bchelf/keyboard-nes/README.md

# keyboard-nes

Remapping order: Right, Left, Down, Up, A, B, Select, Start
