bchelf/keyboard-nes/hardware/kbd-nes-v2/kbd-nes-v2.kicad_pcb

## KiCad design hardware/kbd-nes-v2/kbd-nes-v2.kicad_pcb (2026-05-14)

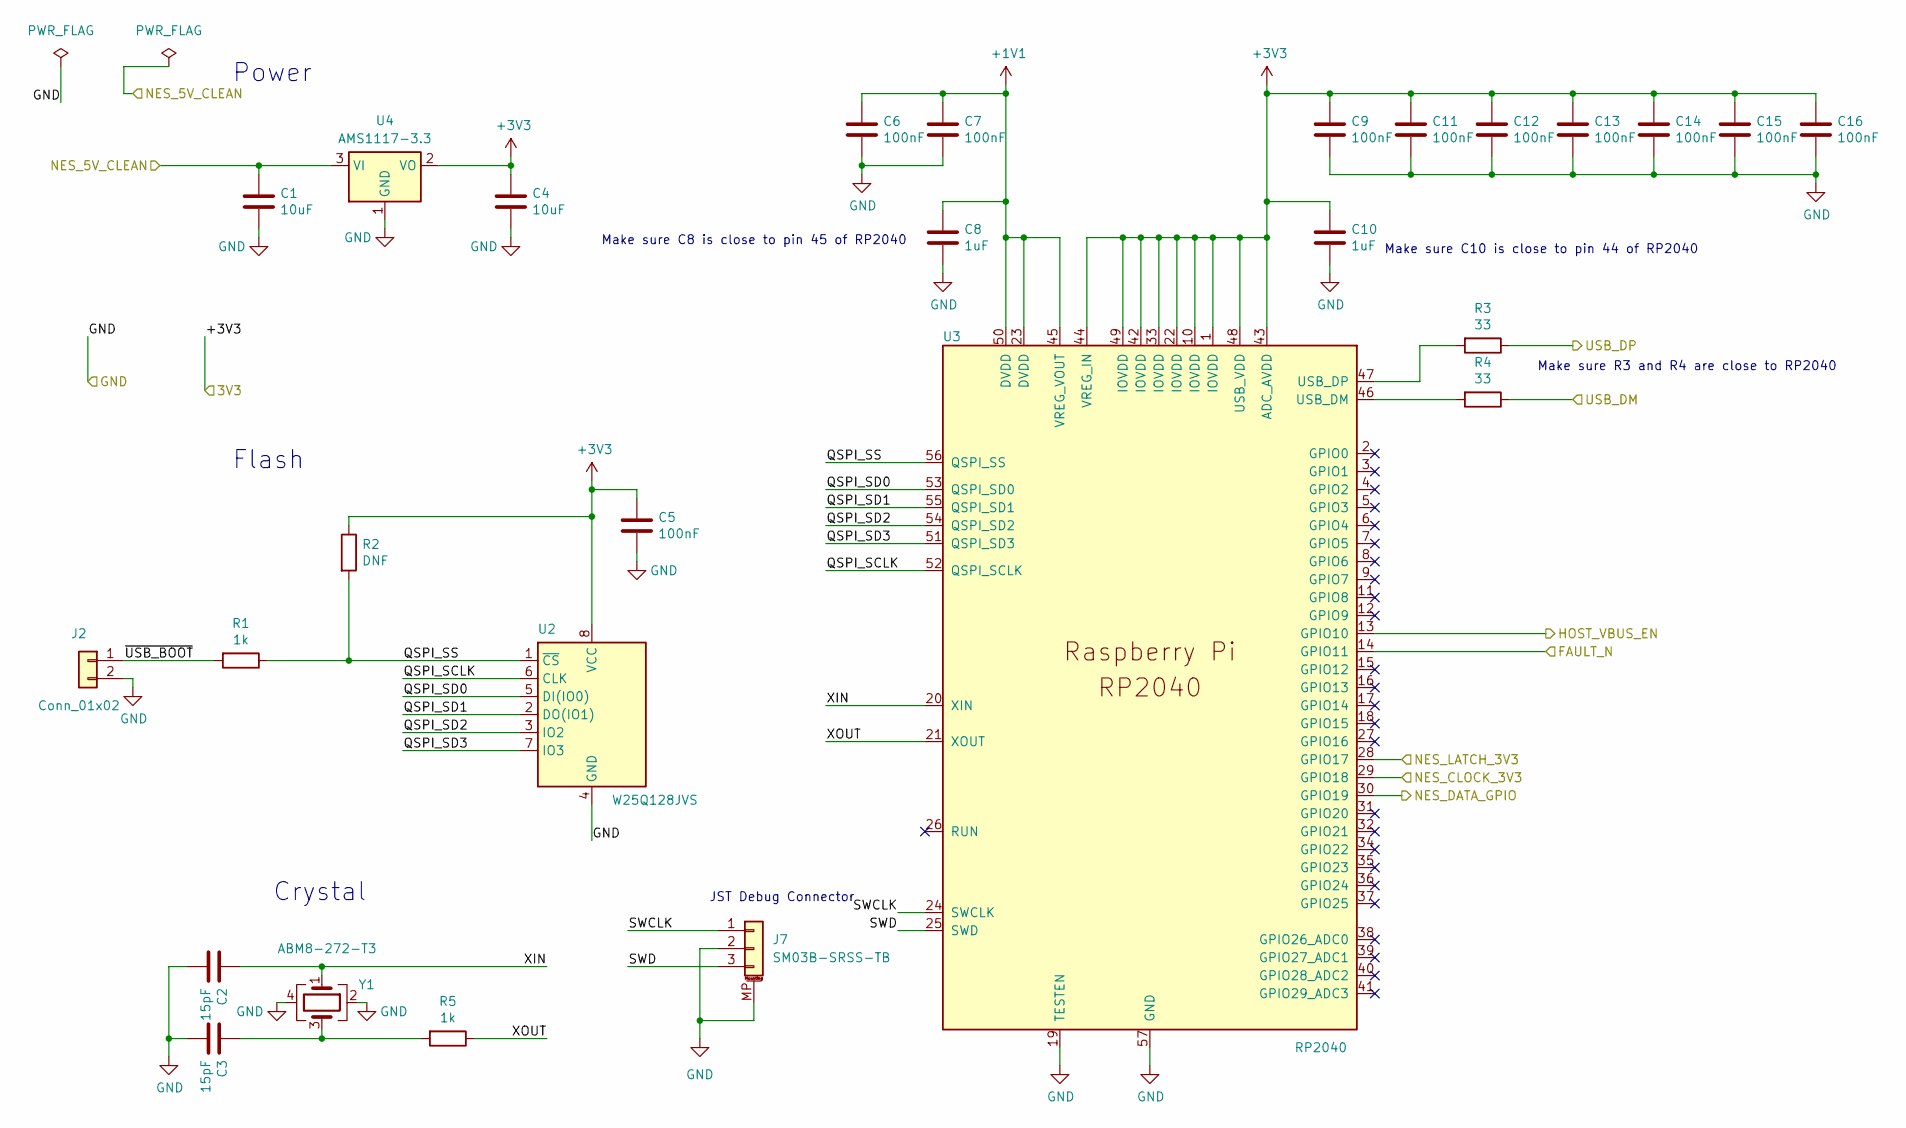
[picture p1: schematic rp2040_core.kicad_sch]

Parts:
C1, C4: 10uF; C_0603_1608Metric; LCSC C19702
C2, C3: 15pF; C_0402_1005Metric; LCSC C1548
C5, C6, C7, C9, C11, C12, C13, C14, C15, C16: 100nF; C_0402_1005Metric; LCSC C307331
C8, C10: 1uF; C_0402_1005Metric; LCSC C52923
J2: Conn_01x02; PinHeader_1x02_P2.54mm_Vertical
J7: SM03B-SRSS-TB; JST_SH_SM03B-SRSS-TB_1x03-1MP_P1.00mm_Horizontal; LCSC C160403
R1, R5: 1k; R_0402_1005Metric; LCSC C11702
R2: DNF; R_0402_1005Metric
R3, R4: 33; R_0402_1005Metric; LCSC C25105
U2: W25Q128JVS; SOIC-8_5.3x5.3mm_P1.27mm; LCSC C97521
U3: RP2040; QFN-56-1EP_7x7mm_P0.4mm_EP3.2x3.2mm_ThermalVias; LCSC C2040
U4: AMS1117-3.3; SOT-223-3_TabPin2; LCSC C6186
Y1: ABM8-272-T3; Crystal_SMD_3225-4Pin_3.2x2.5mm; LCSC C20625731

Connections:
+1V1: C6.1, C7.1, C8.1, U3.23 (DVDD), U3.45 (VREG_VOUT), U3.50 (DVDD)
+3V3: C4.1, C5.1, C9.1, C10.1, C11.1, C12.1, C13.1, C14.1, C15.1, C16.1, R2.1, U2.8 (VCC), U3.1 (IOVDD), U3.10 (IOVDD), U3.22 (IOVDD), U3.33 (IOVDD), U3.42 (IOVDD), U3.43 (ADC_AVDD), U3.44 (VREG_IN), U3.48 (USB_VDD), U3.49 (IOVDD), U4.2 (VO); also elsewhere on the board
/NES Input Output/NES_5V_CLEAN: C1.1, U4.3 (VI); also elsewhere on the board
/NES Input Output/NES_CLOCK_3V3: U3.29 (GPIO18); also elsewhere on the board
/NES Input Output/NES_DATA_GPIO: U3.30 (GPIO19); also elsewhere on the board
/NES Input Output/NES_LATCH_3V3: U3.28 (GPIO17); also elsewhere on the board
/RP2040 Core/FAULT_N: U3.14 (GPIO11); also elsewhere on the board
/RP2040 Core/HOST_VBUS_EN: U3.13 (GPIO10); also elsewhere on the board
/RP2040 Core/QSPI_SCLK: U2.6 (CLK), U3.52 (QSPI_SCLK)
/RP2040 Core/QSPI_SD0: U2.5 (DI(IO0)), U3.53 (QSPI_SD0)
/RP2040 Core/QSPI_SD1: U2.2 (DO(IO1)), U3.55 (QSPI_SD1)
/RP2040 Core/QSPI_SD2: U2.3 (IO2), U3.54 (QSPI_SD2)
/RP2040 Core/QSPI_SD3: U2.7 (IO3), U3.51 (QSPI_SD3)
/RP2040 Core/QSPI_SS: R1.1, R2.2, U2.1 (~CS), U3.56 (QSPI_SS)
/RP2040 Core/SWCLK: J7.1, U3.24 (SWCLK)
/RP2040 Core/SWD: J7.3, U3.25 (SWD)
/RP2040 Core/USB_DM: R4.1; also elsewhere on the board
/RP2040 Core/USB_DP: R3.1; also elsewhere on the board
/RP2040 Core/XIN: C2.1, U3.20 (XIN), Y1.1
/RP2040 Core/XOUT: R5.1, U3.21 (XOUT)
/RP2040 Core/~USB_BOOT: J2.1, R1.2
GND: C1.2, C2.2, C3.2, C4.2, C5.2, C6.2, C7.2, C8.2, C9.2, C10.2, C11.2, C12.2, C13.2, C14.2, C15.2, C16.2, J2.2, J7.2, J7.MP (MountPin), U2.4 (GND), U3.19 (TESTEN), U3.57 (GND), U4.1 (GND), Y1.2, Y1.4; also elsewhere on the board
unnamed: C3.1, R5.2, Y1.3
unnamed: R4.2, U3.46 (USB_DM)
unnamed: R3.2, U3.47 (USB_DP)

Notes on the sheet:
Make sure R3 and R4 are close to RP2040
JST Debug Connector
Crystal
Flash
Make sure C8 is close to pin 45 of RP2040
Make sure C10 is close to pin 44 of RP2040
Power

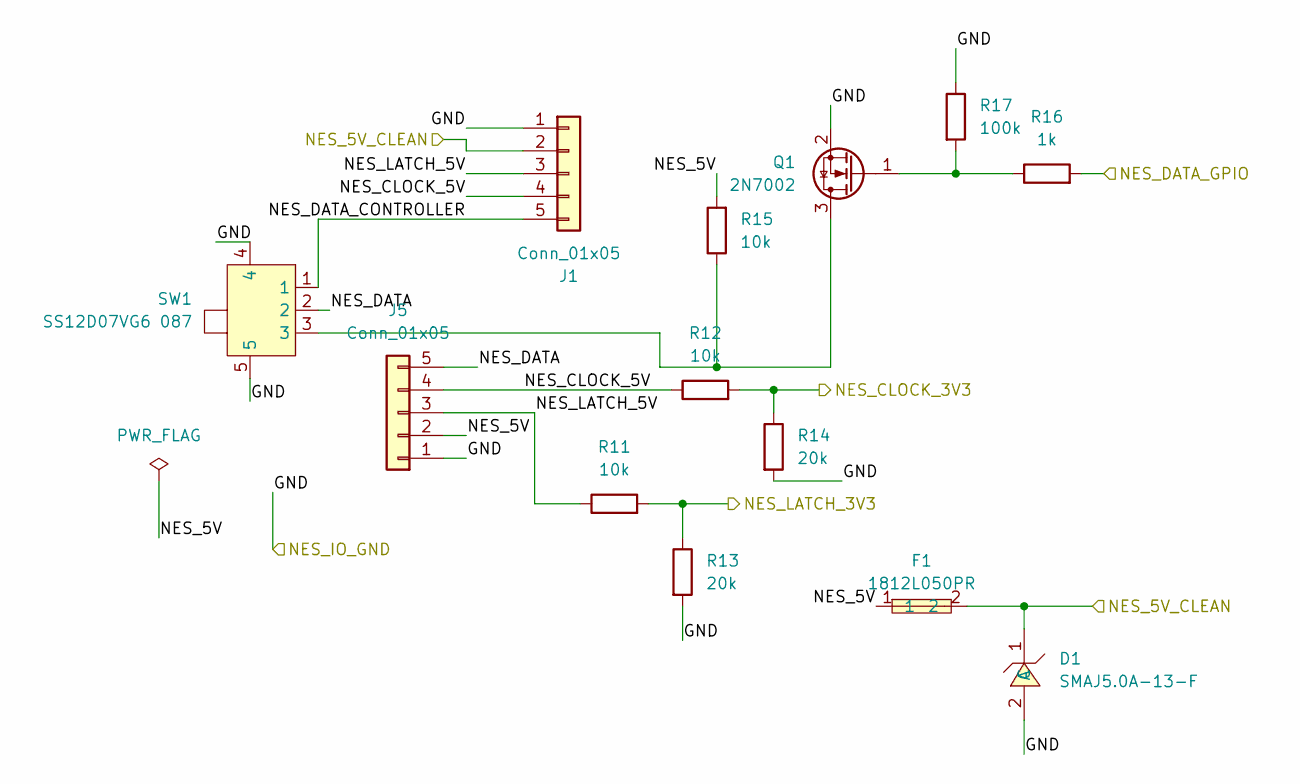
[picture p2: schematic nes_io.kicad_sch]

Parts:
D1: SMAJ5.0A-13-F; SMA_L4.3-W2.6-LS5.2-RD; MPN SMAJ5.0A-13-F; LCSC C87074
F1: 1812L050PR; F1812; MPN 1812L050PR; LCSC C151169
J1, J5: Conn_01x05; JST_PH_S5B-PH-SM4-TB_1x05-1MP_P2.00mm_Horizontal; LCSC C265104
Q1: 2N7002; SOT-23; LCSC C8545
R11, R12, R15: 10k; R_0402_1005Metric; LCSC C25744
R13, R14: 20k; R_0402_1005Metric; LCSC C25765
R16: 1k; R_0402_1005Metric; LCSC C11702
R17: 100k; R_0402_1005Metric; LCSC C25741
SW1: SS12D07VG6 087; SW-TH_SS12D07VG4; MPN SS12D07VG6 087; LCSC C2939728

Connections:
/NES Input Output/NES_5V: F1.1, J5.2, R15.2
/NES Input Output/NES_5V_CLEAN: D1.1 (C), F1.2, J1.2; also elsewhere on the board
/NES Input Output/NES_CLOCK_3V3: R12.2, R14.1; also elsewhere on the board
/NES Input Output/NES_CLOCK_5V: J1.4, J5.4, R12.1
/NES Input Output/NES_DATA: J5.5, SW1.2
/NES Input Output/NES_DATA_CONTROLLER: J1.5, SW1.1
/NES Input Output/NES_DATA_GPIO: R16.2; also elsewhere on the board
/NES Input Output/NES_LATCH_3V3: R11.2, R13.1; also elsewhere on the board
/NES Input Output/NES_LATCH_5V: J1.3, J5.3, R11.1
GND: D1.2 (A), J1.1, J5.1, Q1.2 (S), R13.2, R14.2, R17.1, SW1.4, SW1.5; also elsewhere on the board
unnamed: Q1.3 (D), R15.1, SW1.3
unnamed: Q1.1 (G), R16.1, R17.2

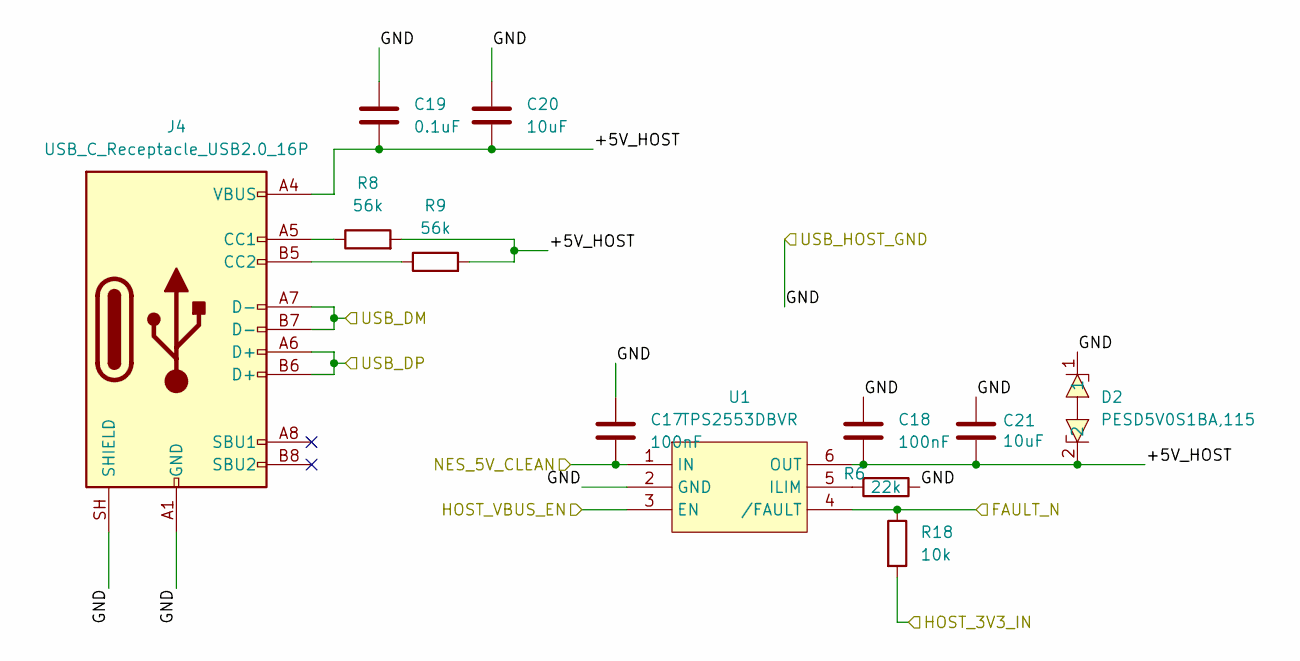
[picture p3: schematic usb_keyboard_host.kicad_sch]

Parts:
C17, C18: 100nF; C_0402_1005Metric; LCSC C307331
C19: 0.1uF; C_0402_1005Metric; LCSC C307331
C20: 10uF; C_0603_1608Metric
C21: 10uF; C_0603_1608Metric; LCSC C19702
D2: PESD5V0S1BA,115; SOD-323_L1.7-W1.3-LS2.5-BI; MPN PESD5V0S1BA,115; LCSC C19224
J4: USB_C_Receptacle_USB2.0_16P; USB_C_Receptacle_HRO_TYPE-C-31-M-12; LCSC C165948
R6: 22k; R_0402_1005Metric; LCSC C25768
R8, R9: 56k; R_0603_1608Metric; LCSC C23206
R18: 10k; R_0402_1005Metric; LCSC C25744
U1: TPS2553DBVR; SOT-23-6_L2.9-W1.6-P0.95-LS2.8-BR; MPN TPS2553DBVR; LCSC C55266

Connections:
+3V3: R18.2; also elsewhere on the board
/NES Input Output/NES_5V_CLEAN: C17.2, U1.1 (IN); also elsewhere on the board
/RP2040 Core/FAULT_N: R18.1, U1.4 (/FAULT); also elsewhere on the board
/RP2040 Core/HOST_VBUS_EN: U1.3 (EN); also elsewhere on the board
/RP2040 Core/USB_DM: J4.A7 (D-), J4.B7 (D-); also elsewhere on the board
/RP2040 Core/USB_DP: J4.A6 (D+), J4.B6 (D+); also elsewhere on the board
/USB Keyboard Host/+5V_HOST: C18.2, C19.1, C20.1, C21.2, D2.2, J4.A4 (VBUS), J4.A9 (VBUS), J4.B4 (VBUS), J4.B9 (VBUS), R8.2, R9.2, U1.6 (OUT)
GND: C17.1, C18.1, C19.2, C20.2, C21.1, D2.1, J4.A1 (GND), J4.A12 (GND), J4.B1 (GND), J4.B12 (GND), J4.SH (SHIELD), R6.1, U1.2 (GND); also elsewhere on the board
unnamed: J4.A5 (CC1), R8.1
unnamed: J4.B5 (CC2), R9.1
unnamed: R6.2, U1.5 (ILIM)

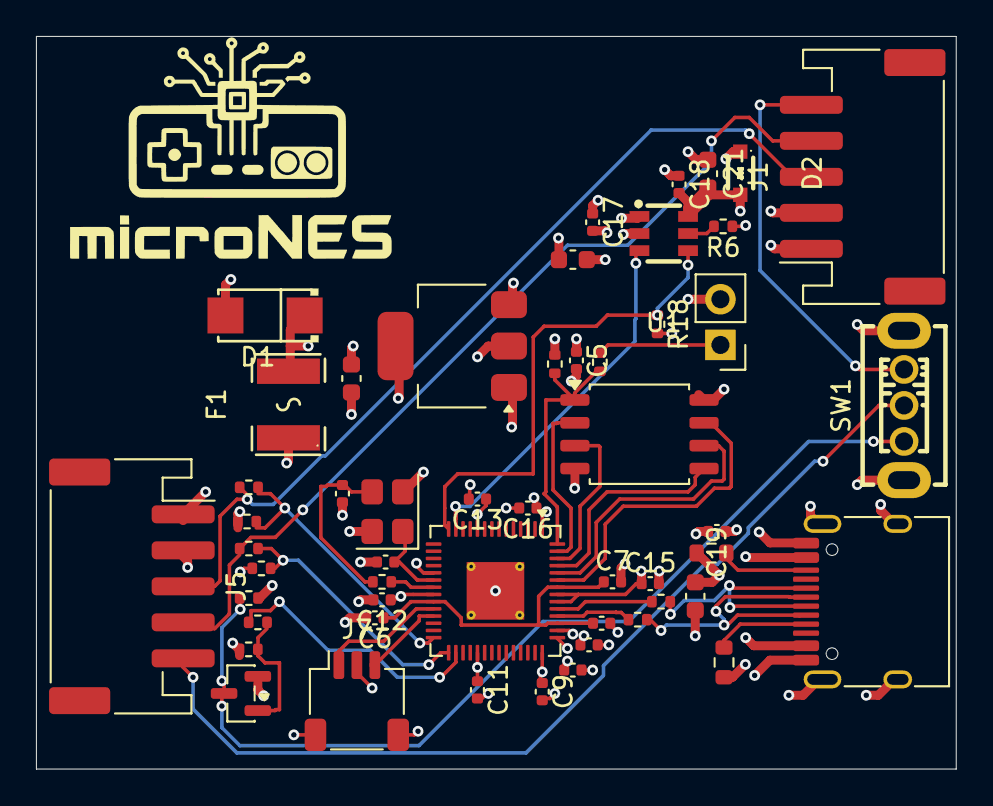
[picture p4: board kbd-nes-v2.kicad_pcb from above]

Board: 4 copper layers, 51.1 x 40.7 mm, 52 parts (0 on the bottom side), 36 nets.
