bchelf/keyboard-nes/(commit log)

2026-04-07 codex fixes to make button presses more reliable - only latency left
2026-04-07 First attempt at latency fixes
    [key_bindings.h, main.c]
2026-04-07 remove printfs to reduce lag haha
2026-04-15 hardware implementation phase 1
    [kbd-nes-v1.kicad_pcb, kbd-nes-v1.kicad_sch, nes-io.kicad_sch, nes_io.kicad_sch, prog_tagconn.kicad_sch, programming_tagconnect.kicad_sch, rp2040-block.kicad_sch, rp2040_core.kicad_sch]
2026-04-16 final submitted CAD to JLC
    [kbd-nes-v1-B_Cu.gbl, kbd-nes-v1-B_Mask.gbs, kbd-nes-v1-B_Silkscreen.gbo, kbd-nes-v1-Edge_Cuts.gm1, kbd-nes-v1-F_Cu.gtl, kbd-nes-v1-F_Mask.gts, kbd-nes-v1-F_Paste.gtp, kbd-nes-v1-F_Silkscreen.gto]
2026-04-28 fix polarity of NES data pin
    [kbd-nes-v1.kicad_pcb]
2026-05-14 add v2 board with switch
    [kbd-nes-v2-B_Cu.gbl, kbd-nes-v2-B_Mask.gbs, kbd-nes-v2-B_Silkscreen.gbo, kbd-nes-v2-Edge_Cuts.gm1, kbd-nes-v2-F_Cu.gtl, kbd-nes-v2-F_Mask.gts, kbd-nes-v2-F_Paste.gtp, kbd-nes-v2-F_Silkscreen.gto]
2026-05-14 Add key bindings reset - need to test - and also fix schematic and PCB for diode
    [kbd-nes-v2.kicad_pcb, nes_io.kicad_sch]
